OneAudio/AA2380-MAXV_TSTQ9.1/README.md

# AA2380-MAXV_TSTQ9.1
AA2380 CPLD debug version for quartus 9.1 only
