OneAudio/AA2380-MAXV_TSTQ9.1/_Documents/HPF_DCcalibration.pdf

Date: August 21, 2019 | HPF_DCcalibration.bdf | Project: 10M08EVM_Test
Page 1 of 1 | Revision: 10M08EVM_Test

MULT[39..0]

MULT[23..0]

SEL[0]

SEL[1]

SEL[1..0]

FS_CLK

DCA[39..16]

FS_CLK | MULT[39..24] | DATAAC[23]
DCA[39..0] | DC[39..0]

FS_CLK

Dynamic DC removal filter
From application note Xylinx Ref :
24 bits data input and output.
The k factor is 1 / 65536 (16 bit are added to the accumulator). That give a time constant for 192kHz sampling rate (input clock) of 2.35s for reach 1/1000 error.
RC= Tsx n = 5.21e-6 x 65536 = 0.341s
For 0.1% error (1/1000), t= -RC ln 0.001 = 2.35 s
For 0.06 ppm error (24 bits) , t= -RC ln 0.06e-6 = 5.7 s

The autozero minimum time for each sampling rate (48k,96k and 192kHz), to reach the 24bits accuracy is :
RC@48k = 1.36s
RC@96k = 0.683 s
RC@192k= 0.341 s

For 0.06 ppm error (24 bits) , t= -0.341 ln 0.06e-6 = 5.7 s @ 192 kHz

For 0.06 ppm error (24 bits) , t= -0.683 ln 0.06e-6 = 11.35 s @ 96 kHz

For 0.06 ppm error (24 bits) , t= -1.36 ln 0.06e-6 = 22.6 s @ 48kHz

With a clock of 375ms period (50MHz/18750000), w e need an integer number

64 * 0375s = 24s (48kHz) // 32 * 0375s = 12s (96kHz) // 16 * 0375s = 6s (192kHz)

of period for each calibration time :

The 50MHz main input clock must be divided by 18 750 000 to get a 0.375ms period signal.

the final DC value is memorized and HPF is turned off.

Compiled the 06/04/2047 Quartus 9.1 | The CAL input allow to perform DC offset calibration by activating the HPF filter only for a period of calibration time of 6,12 or 24s depending on active sampling rate. When this time is reached,

This function take 138 LE

VCC FS_CLK | INPUT
VCC DATAIN[23..0] | INPUT
ACnDC | VCC INPUT
VCC CAL | INPUT

VCC

PulseCAL | INPUT
OUTPUT | FLTDATA[23..0]
OUTPUT | DATAAC[23..0]

A

B

A-B

dataa[23..0]

datab[23..0]

result[23..0]

Adder24bx2

inst1

A

B

A-B

dataa[23..0]

datab[23..0]

result[23..0]

Adder24bx2

inst8

data2x[23..0]
data1x[23..0]
data0x[23..0]
clock

sel[1..0]

result[23..0]

MUX24BX3

inst19

A

B

A+B

dataa[39..0]

datab[39..0]

result[39..0]

Adder40bX2

inst2

WIRE

inst5

WIRE

inst6 CLRN

D

PRN
Q

DFF

inst14

NOT

inst

AND2

inst23
WIRE

inst24

CLRN

D

PRN
Q

DFF

inst15

AND2

inst25
