OneAudio/AA2380-MAXV_TSTQ9.1/_Documents/2380CPLD.pdf

Date: August 20, 2019 | READ_LTC2380-24_Serial-out_V5.bdf* | Project: LT2380-24_SPDIF
Page 1 of 1 | Revision: LT2380-24_SPDIF

48M152

48M152 | DATAX[23..0]
98M304 | 48M152
| 24M576
| 12M288
| 6M144
| 3072kHz
| 1536kHz
| 768kHz
| 384kHz
| 192kHz
| 96kHz
| 48kHz
| 24kHz
| 12kHz
| 6Hz

FSR

AVG [2..0]

MODE_FIR_nSinc

98M304

FS[1..0]

ADC_BUSY

ADC_SDO

### High speed serial interface to send 24 bits data at 1.6MSPS rate to MAX10 board

VCC ADC_SDO | INPUT
VCC ADC_BUSY | INPUT
VCC 98M304 | INPUT
VCC MODE_FIR_nSinc | INPUT
VCC FS[1..0] | INPUT
VCC DistRead | INPUT
VCC AVG[2..0] | INPUT
OUTPUT | CLKADC
OUTPUT | 12kHz
OUTPUT | 6Hz
OUTPUT | FSAMPLE
OUTPUT | 768kHz
OUTPUT | DATA_SDO
OUTPUT | DATA_CLK
OUTPUT | DATA_ENABLE
OUTPUT | DATA_CLEAR
OUTPUT | nCNV
OUTPUT | xFS128
OUTPUT | DATAX[23..0]
OUTPUT | FSR

VCC

i_clk

i_rst

o_clk_div2

o_clk_div4

o_clk_div8

o_clk_div16

o_clk_div32

o_clk_div64

o_clk_div128

o_clk_div256

o_clk_div512

o_clk_div1024

o_clk_div2048

o_clk_div4096

o_clk_div8192

o_clk_div16777216

clock_div_b

inst12

### LOAD_SAMPLE DIN[23..0] CLOCK

### DATA_SDO DATA_CLK DATA_ENABLE DATA_CLEAR

### Send_ADCDATA

inst4

IN

### CLK

### OUT nOUT

### pulse1clkB

inst10

AND2

inst15

NOT

inst16

NOT

inst17

enable

clock

FS[1..0]

BUSY

SDO

DATAO[23..0]

Fso

nFS

nCNV

SCK

CK128FS

ADC_DistReadX

inst

FIRmode

enable

clock

FS[1..0]

AVG[2..0]

BUSY

SDO

DATAO[23..0]

Fso

nFS

nCNV

SCK

CK128FS

ADC_FastReadX

inst1

DATA1[23..0]

Fso1

nFS1

nCNV1

SCK1

CK128FS1

DATA2[23..0]

Fso2

nFS2

nCNV2

SCK2

CK128FS2

DATA[23..0]

SCK

Fso

nFS

nCNV

CK128FS

Gate_ADCreading

inst2

Date: August 20, 2019 | LT2380-24_SPDIF.bdf* | Project: LT2380-24_SPDIF

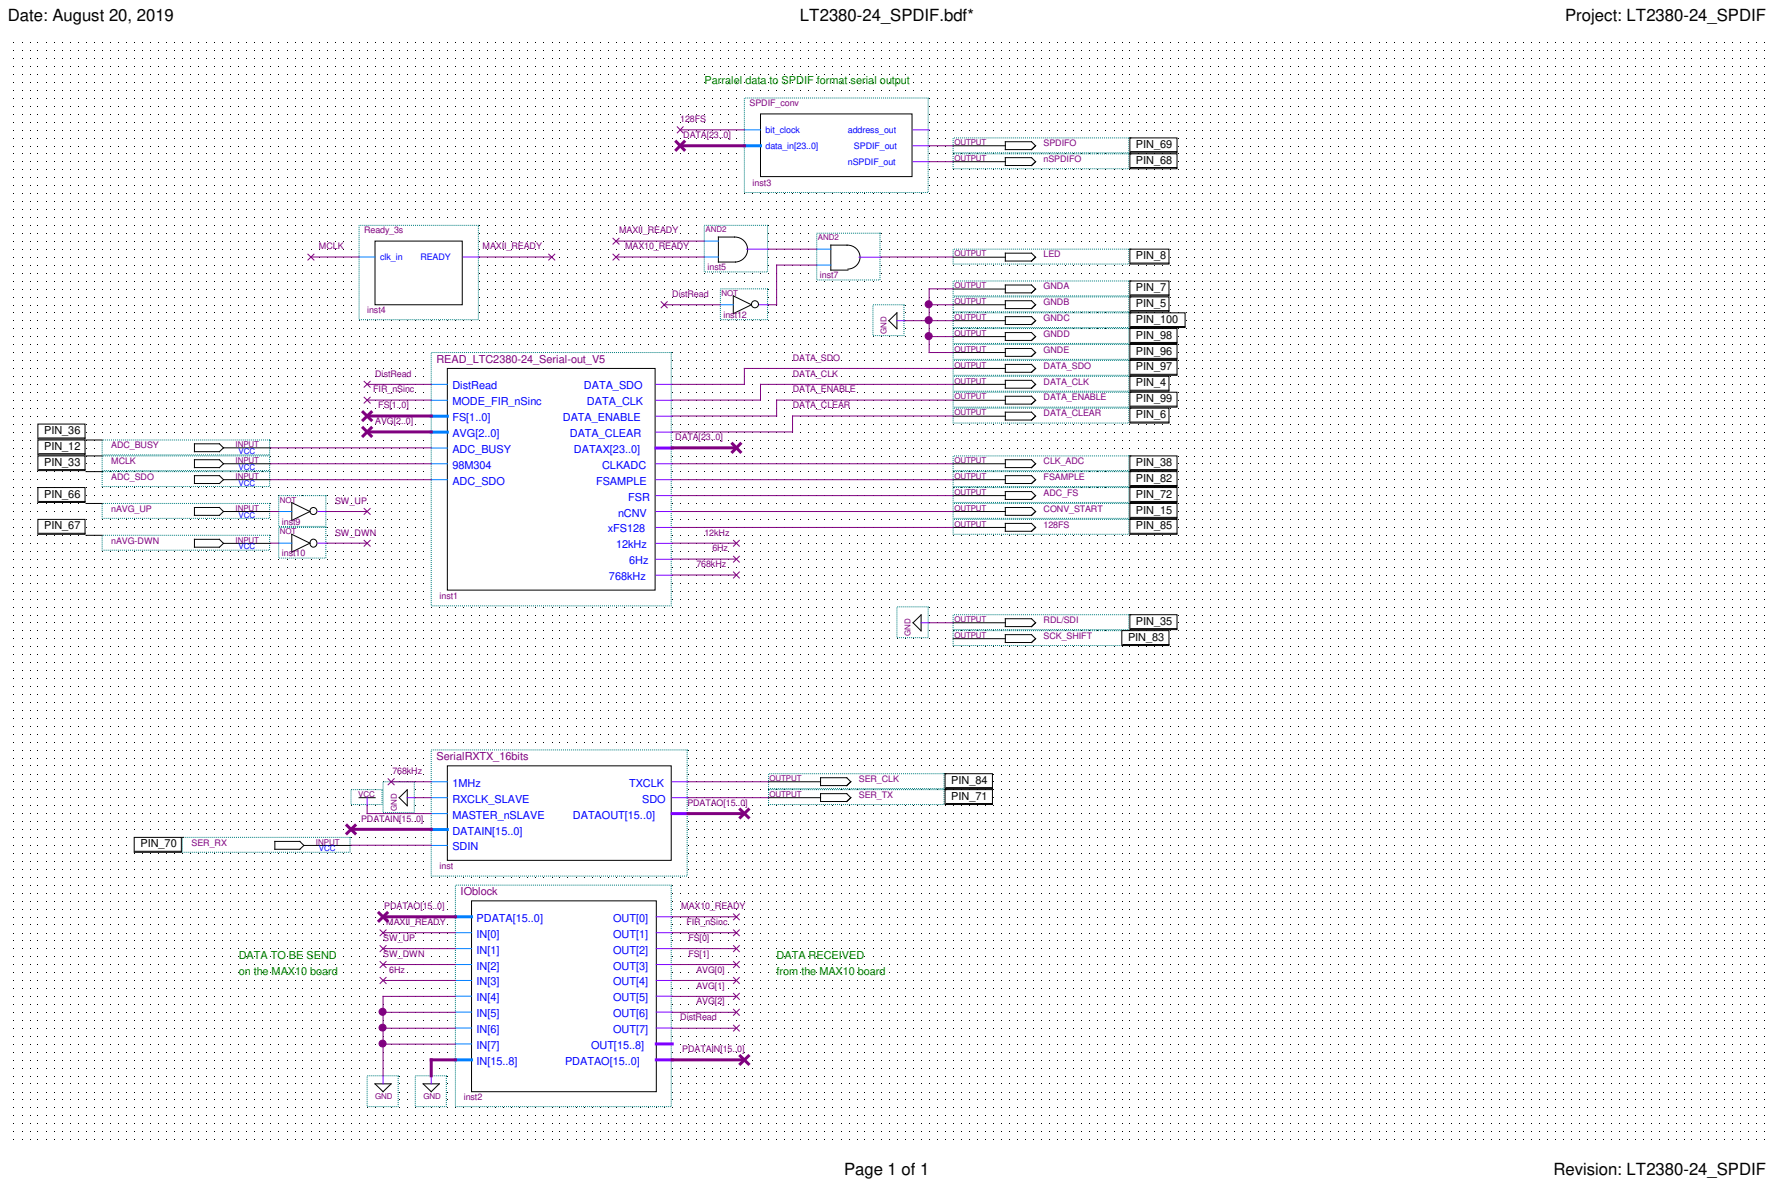
[picture p2: page 2]
Page 1 of 1; Revision: LT2380-24_SPDIF; MCLK; MAXII_READY; MAX10_READY; DATA_SDO; DATA_CLK; DATA_ENABLE; DATA_CLEAR; DistRead; PDATAIN[15..0]; 768kHz; PDATAO[15..0]; SW_DWN; FIR_nSinc; AVG[0]; AVG[1]; AVG[2]; DATA[23..0]; AVG[2..0]; 12kHz; VCC ADC_SDO; INPUT; VCC ADC_BUSY; VCC MCLK; VCC SER_RX; VCC nAVG-DWN; VCC nAVG_UP; OUTPUT; SPDIFO; nSPDIFO; CONV_START; CLK_ADC; RDL/SDI; LED; SER_TX; SER_CLK; ADC_FS; GNDA; GNDB; GNDC; GNDD; GNDE; SCK_SHIFT; FSAMPLE; PDATA[15..0]; OUT[0]; OUT[1]; OUT[2]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

Parralel data to SPDIF format serial output

DATA TO BE SEND
on the MAX10 board

DATA RECEIVED
from the MAX10 board
