OneAudio/AA2380-MAXV_TSTQ9.1/_Version/AA2380_CPLD_V0A.pdf

# OSVA - AA2380 ADC *** CPLD SOFTWARE ARCHITECTURE

## I2S TO S/PDIF

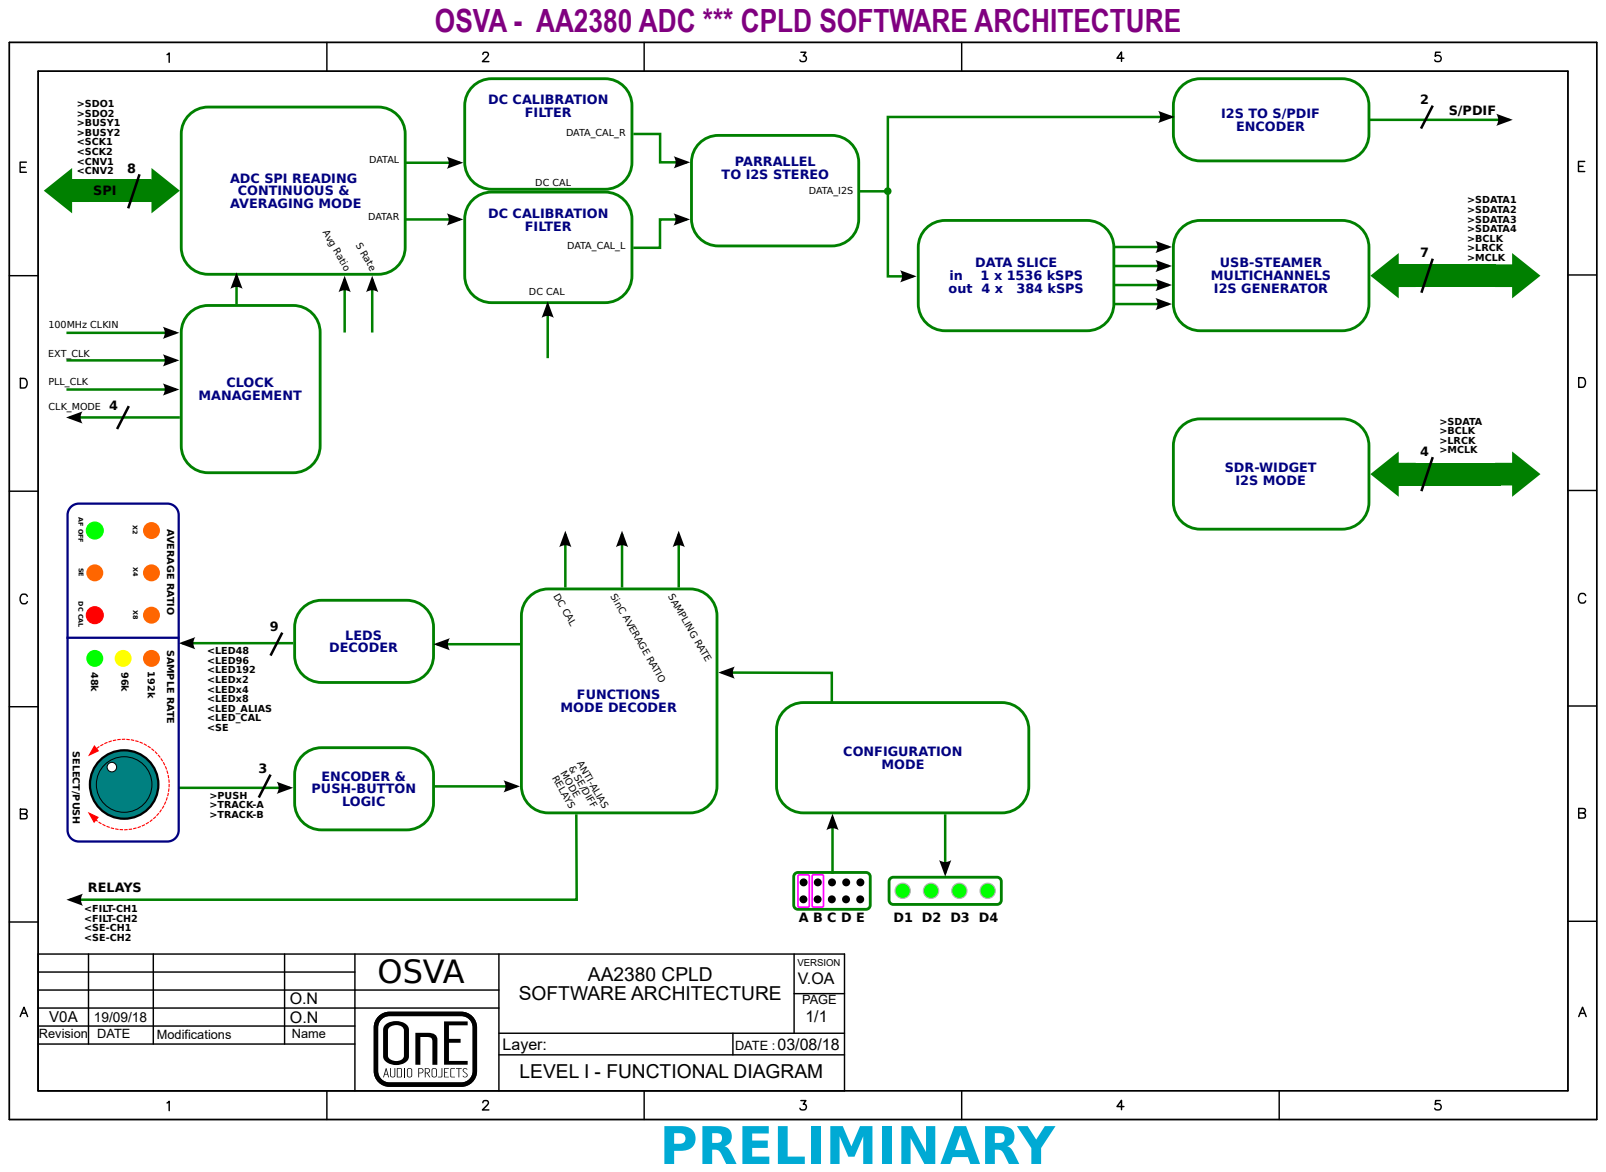
[picture p3: page 1]
DATE :; CLOCK MANAGEMENT; LEDS DECODER; ENCODER; USB-STEAMER MULTICHANNELS I2S GENERATOR; SDR-WIDGET I2S MODE; SPI; S/PDIF; 100MHz CLKIN; EXT_CLK; RELAYS; >SDO1 >SDO2 >BUSY1 >BUSY2 <SCK1 <SCK2 <CNV1 <CNV2; CLK_MODE; >PUSH >TRACK-A >TRACK-B; <LED48 <LED96 <LED192 <LEDx2 <LEDx4 <LEDx8 <LED_ALIAS <LED_CAL <SE; <FILT-CH1 <FILT-CH2 <SE-CH1 <SE-CH2; >SDATA1 >SDATA2 >SDATA3 >SDATA4 >BCLK >LRCK >MCLK; DC CALIBRATION FILTER; >SDATA >BCLK >LRCK >MCLK; ENCODER & PUSH-BUTTON LOGIC; FUNCTIONS MODE DECODER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

ADC SPI READING
CONTINUOUS &
AVERAGING MODE

SELECT/PUSH AF OFF

DC CAL SE

SinC AVERAGE RATIO

OSVA | AA2380 CPLD SOFTWARE ARCHITECTURE | VERSION V.OA

O.N | | | PAGE 1/1

V0A | 19/09/18 | | O.N
Revision | DATE | Modifications | Name

Layer:
LEVEL I - FUNCTIONAL DIAGRAM
PRELIMINARY
