OneAudio/AA2380-MAXV_TSTQ9.1/_Version/AA2380PAN.pdf

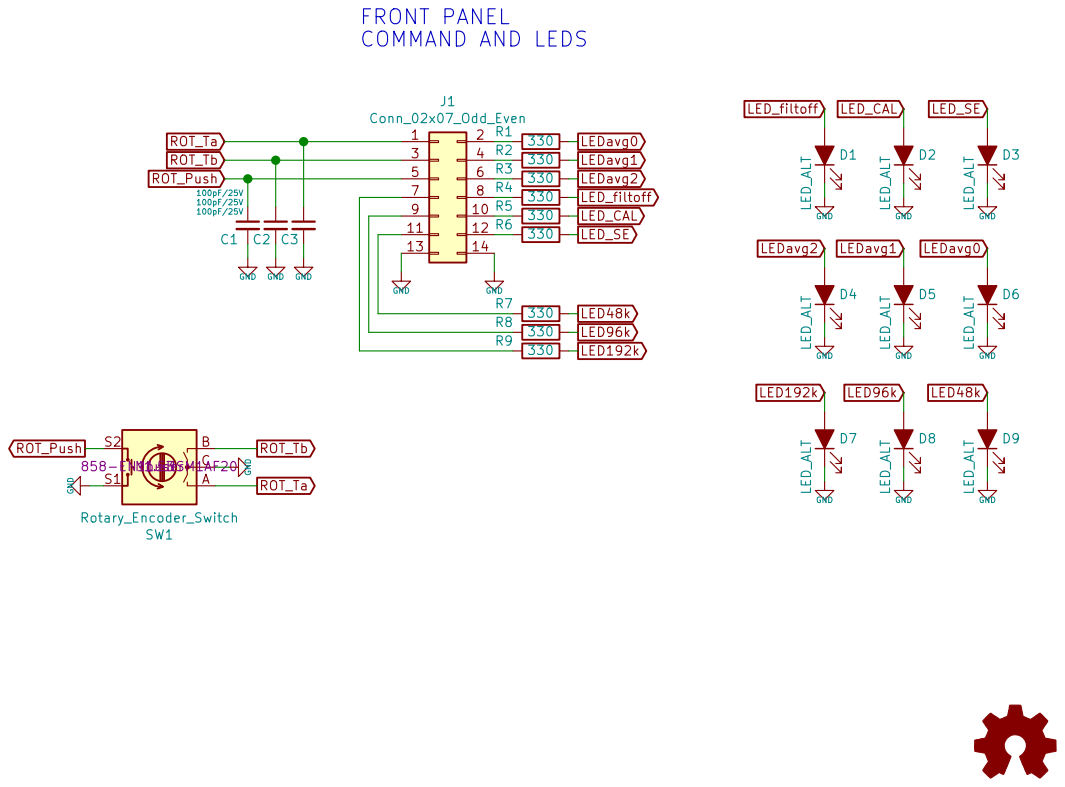
[picture p4: page 1]

9 | 10
11 | 12

File: AA2380PAN.sch Sheet: / OnE Audio Projects

Id: 1/1 Title: OSVA - Panel command PCB
