OneAudio/AA2380-MAXV_TSTQ9.1/_Version/AA2380V1.pdf

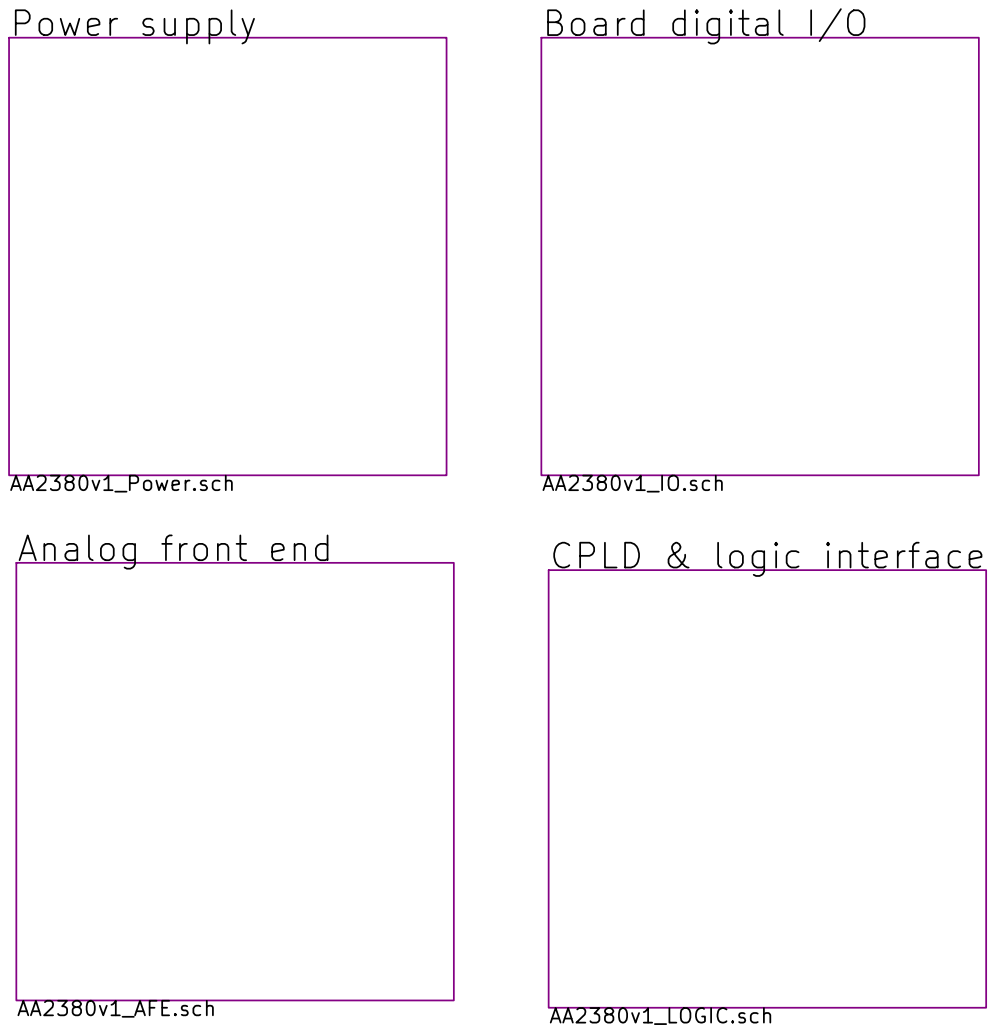
[picture p5: page 1]

Open Source Versatile Analyzer Stand alone dual channels SAR ADCs board Hierarchical view Analog front end

File: AA2380V1.sch Sheet: / OnE Audio PRojects

Id: 1/5 Title: AA2380 OSVA ADC board

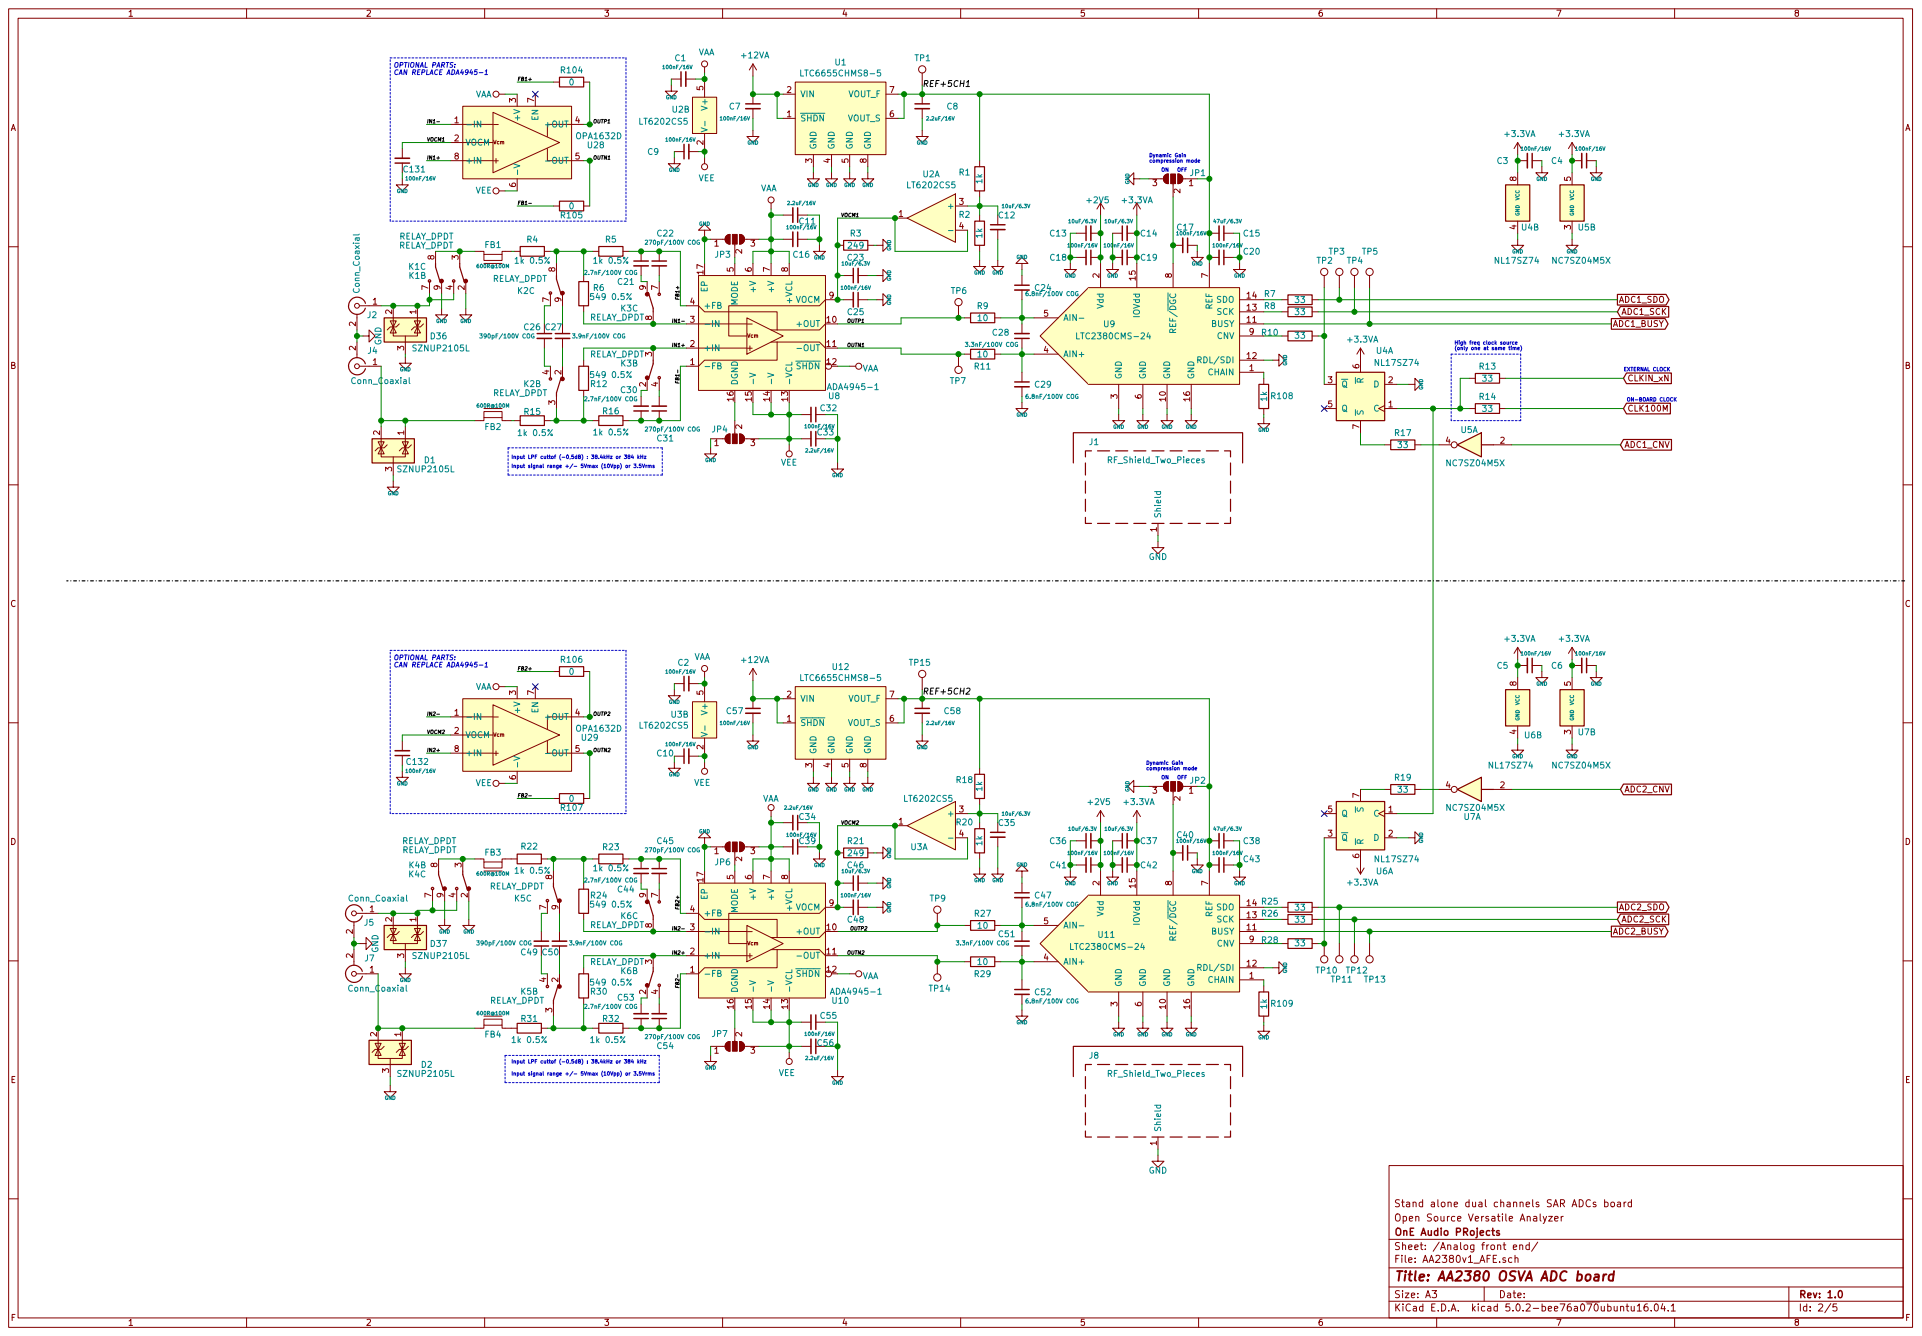
[picture p6: page 2]

OPTIONAL PARTS: CAN REPLACE ADA4945-1

Dynamic Gain
compression mode ON OFF

High freq clock source

Input LPF cuttof (-0,5dB) : 38.4kHz or 384 kHz

Open Source Versatile Analyzer Stand alone dual channels SAR ADCs board

OnE Audio PRojects
Sheet: /Analog front end/
File: AA2380v1_AFE.sch
Id: 2/5 Title: AA2380 OSVA ADC board

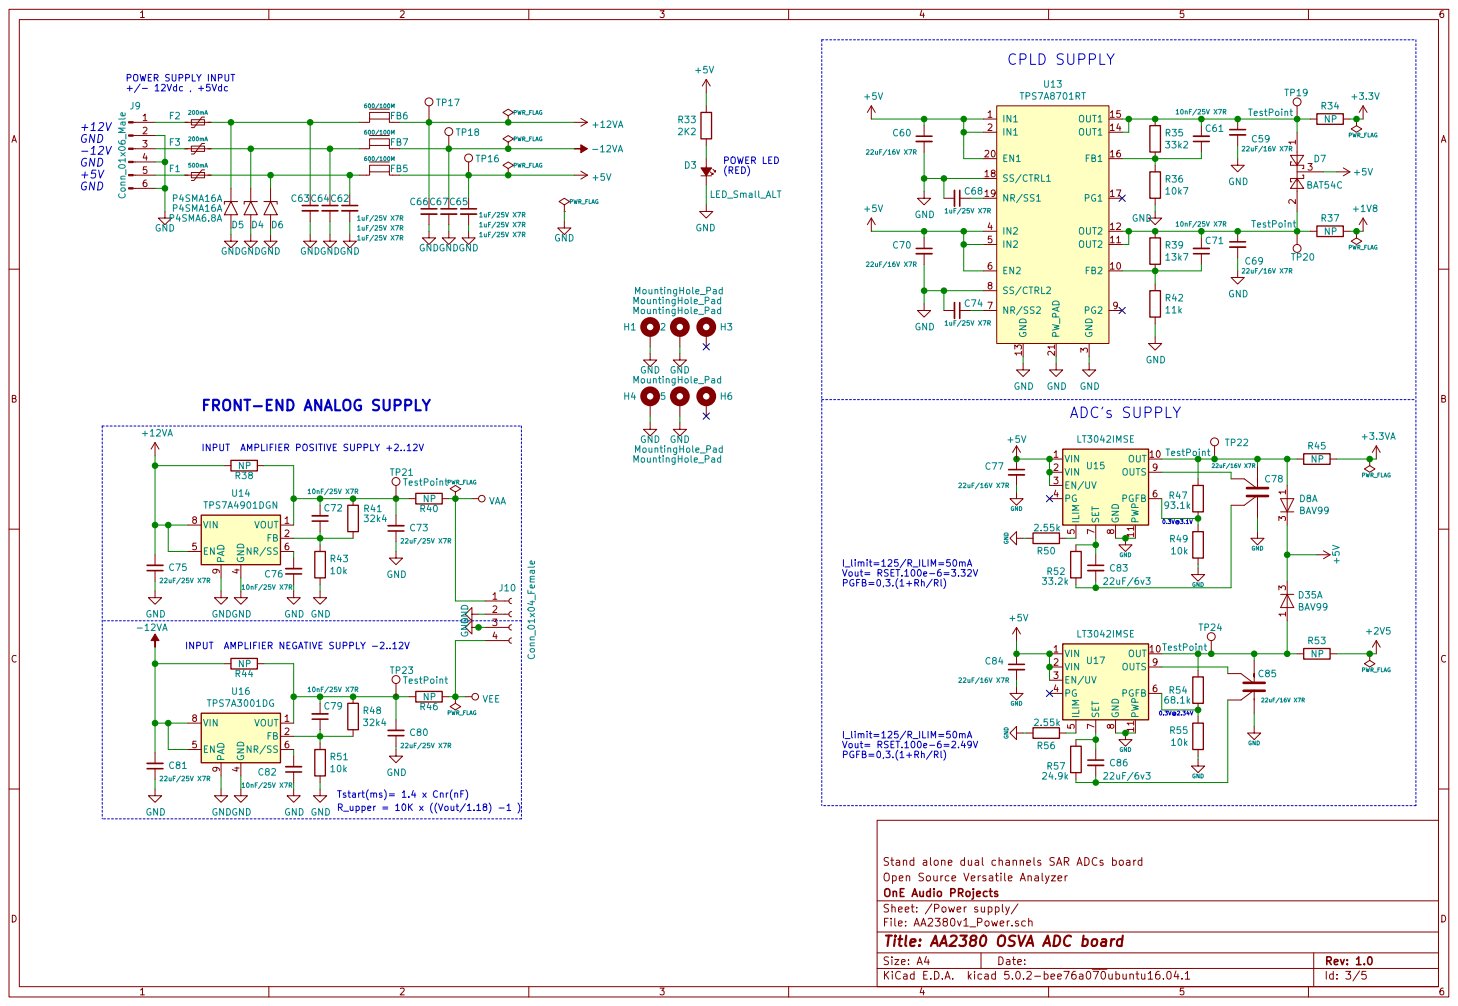
[picture p7: page 3]

(RED) POWER SUPPLY INPUT

1uF/25V X7R Tstart(ms)= 1.4 x Cnr(nF)

INPUT AMPLIFIER POSITIVE SUPPLY +2..12V

4 EN 5 NR/SS 6 VIN 8 PAD

R_upper = 10K x ((Vout/1.18) -1 ) | 4

Open Source Versatile Analyzer Stand alone dual channels SAR ADCs board OnE Audio PRojects

Sheet: /Power supply/
File: AA2380v1_Power.sch
Id: 3/5 Title: AA2380 OSVA ADC board

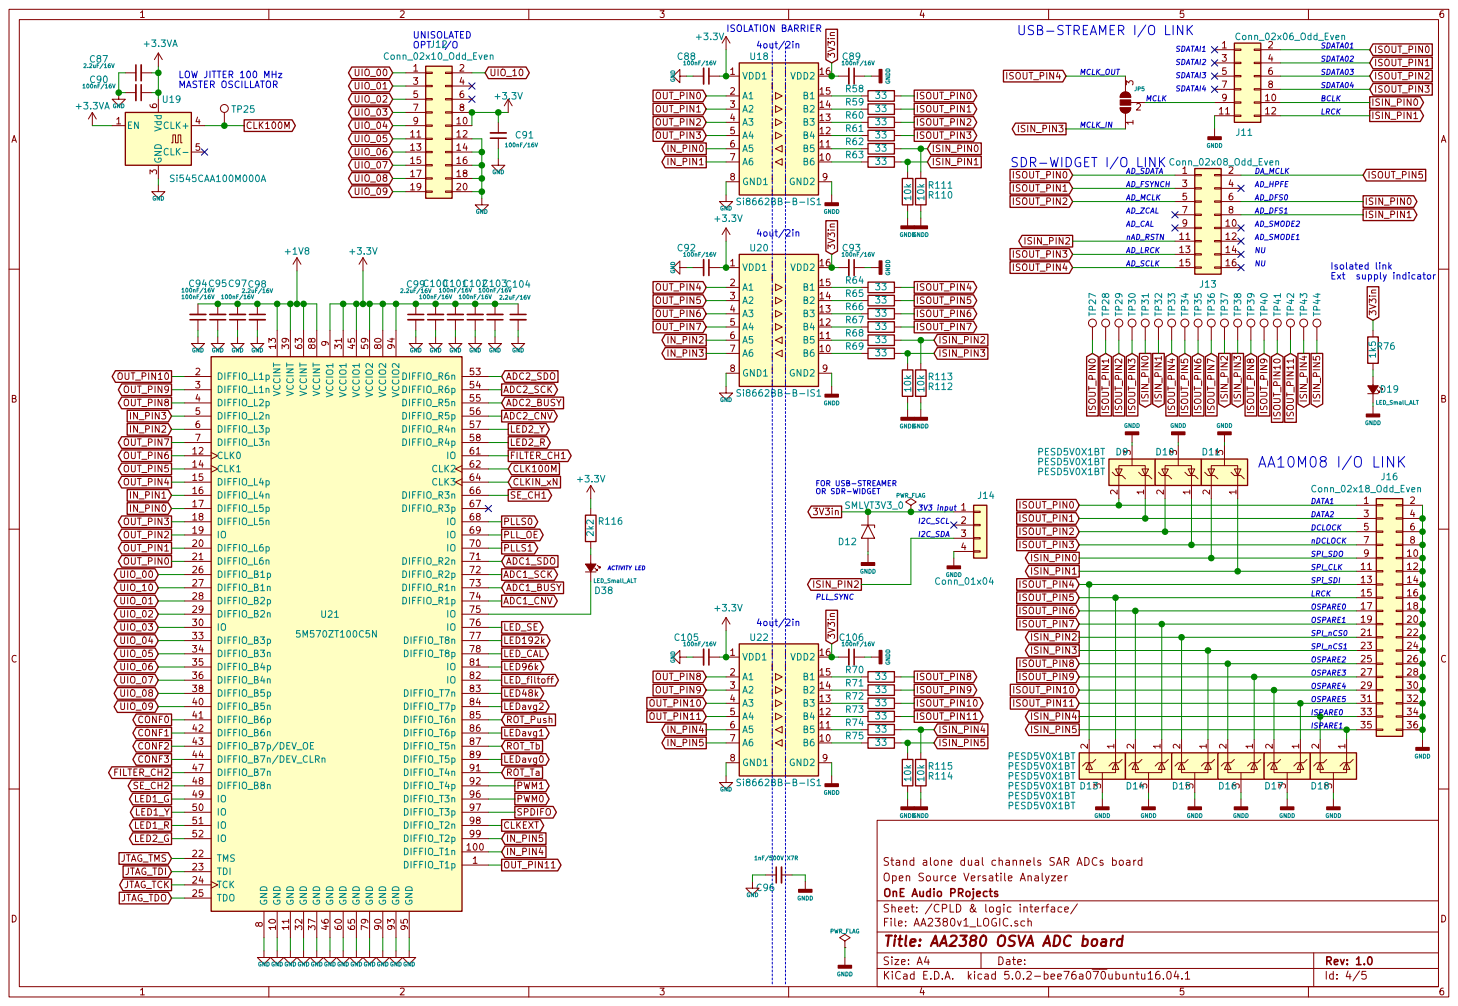
[picture p8: page 4]

LOW JITTER 100 MHz MASTER OSCILLATOR

100nF/16V GND GND GND GND GND +1V8 C98

Isolated link Ext supply indicator

FOR USB-STREAMER OR SDR-WIDGET LED1_Y
IN_PIN1
IN_PIN0

LRCK DATA2 SPI_SDO 7 | 8

SPI_CLK 11 | 12

15 | | 16
17 | | 18
19 | | 20
21 | | 22
23 | | 24
25 | | 26
27 | | 28
29 | | 30
31 | | 32

33 ISPARE0 | | 34

Open Source Versatile Analyzer Stand alone dual channels SAR ADCs board

OnE Audio PRojects
Sheet: /CPLD & logic interface/
File: AA2380v1_LOGIC.sch
Id: 4/5 Title: AA2380 OSVA ADC board

GND GND GND GND GND GND GND GND GND GND GND

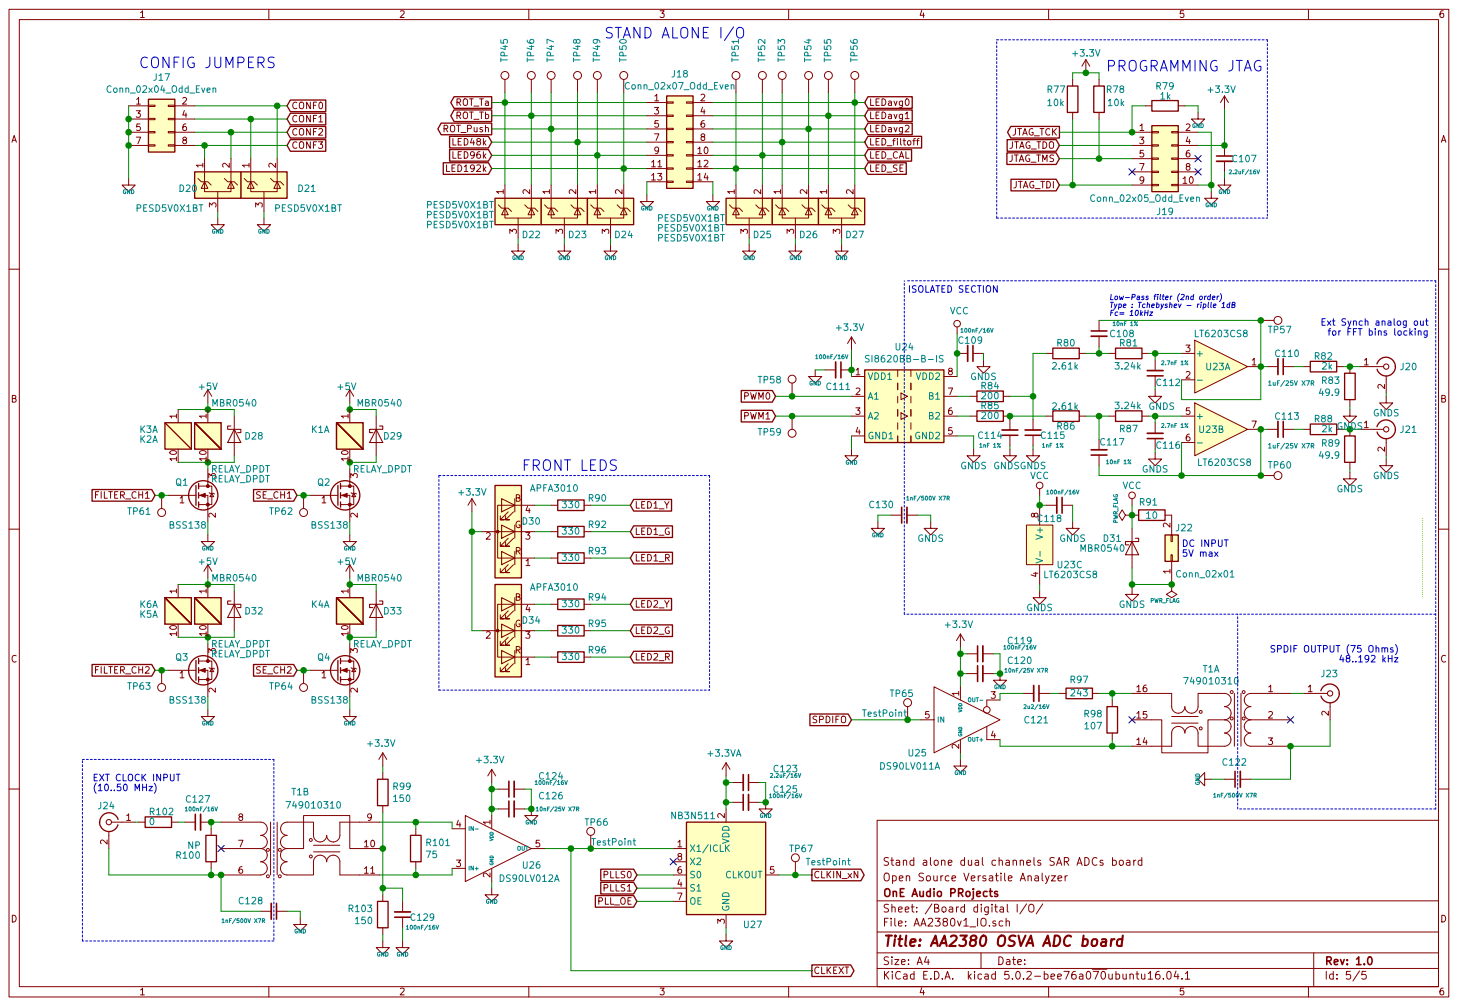
[picture p9: page 5]

Ext Synch analog out
for FFT bins locking

Open Source Versatile Analyzer Stand alone dual channels SAR ADCs board

OnE Audio PRojects
Sheet: /Board digital I/O/
File: AA2380v1_IO.sch
Id: 5/5 Title: AA2380 OSVA ADC board
