OneAudio/AA2380-MAXV_TSTQ9.1/(commit log)

2024-01-24 initial commit of test version in Q9.1
    [AA2380_MAXV_TEST.csv, DistributedRead.xls, F1_readADC_multimodes.xls]
2024-01-30 update F1_readADC_multimodes for bug correction. To be tested (unfinished) -> must work now for AVG=0 -> distributed read not fully work
    [F1_readADC_multimodes.vhd]
2024-01-31 fix cnv inversion on simulated adc vhdl box
2024-02-13 big update to solve sync issue.
    [F1_readADC_multimodes.vhd, F20_EmulateADC.vhd]
2024-02-14 work ok in any mode. To be tested in Q16.1 with AA2380 board.
2024-03-01 Add new multiple clock block using "clock enable" to avoid skew (to be tested & finished)
    [F0_ClockEnable_BETA1.vhd, F0_ClockEnable_BETA2.vhd, F0_NOClockEnable.vhd]
2024-03-06 Correct sync issue on dist read mode ok.
    [F0_ClockEnable_BETA2.vhd]
2024-03-06 Synch issue solved, but issue with some ReadClk value (too low, see notes). In Normal mode, still issue with high sample rate (1536k).
    [F0_ClockEnable_BETA2.vhd]
2024-03-07 Update" F0_ClockEnable_BETA2.vhd" file with new table for each SR/AVG value to choose the right ReadClock value.
    [DistributedRead.xls, F1_readADC_multimodes.xls]
2025-02-04 Créé à l'aide de Colab
